figitaki/Puffin/Puffin.csv

Id | Designator | Footprint | Quantity | Designation | Supplier and ref
1 | S43,S39,S17,S6,S19,S18,S45,S25,S28,S33,S44,S47,S23,S2,S31,S21,S16,S51,S49,S9,S14,S10,S32,S27,S50,S5,S41,S36,S1,S12,S24,S48,S40,S35,S26,S29,S15,S3,S11,S22,S30,S4,S42,S7,S34,S20,S37,S8,S38,S46,S13 | SW_Hotswap_Kailh_Choc_V1_1.00u | 51 | Keyswitch
2 | U2 | DIP762W50P254L1018H450Q8 | 1 | 6N138
3 | R3 | R_0805_2012Metric | 1 | 220R
4 | J2 | CUI_SJ1-3515 | 1 | MIDI IN | Same Sky SJ1-3515
5 | ST2,ST1 | STAB_choc_2u | 2 | choc_stab
6 | J1 | OLED_128x32 | 1 | OLED_128x32
7 | U1 | ProS3_TH | 1 | ProS3
8 | D53,D54,D55,D56 | D_SOD-323_HandSoldering | 4 | BAT54WS | Diodes Inc BAT54WS-7-F
9 | J3 | CUI_SJ1-3515 | 1 | MIDI OUT | Same Sky SJ1-3515
10 | R2 | R_0805_2012Metric | 1 | 470R
11 | D28,D40,D10,D33,D11,D39,D26,D35,D14,D25,D29,D19,D9,D18,D32,D12,D27,D23,D16,D20,D6,D51,D21,D44,D37,D7,D5,D1,D34,D38,D24,D49,D47,D50,D41,D15,D45,D22,D3,D43,D36,D46,D42,D48,D13,D4,D8,D31,D2,D30,D17 | Nexperia_CFP3_SOD-123W | 51 | D_Small
12 | C32,C10,C23,C45,C15,C25,C34,C13,C36,C14,C6,C31,C18,C46,C26,C9,C11,C4,C48,C39,C5,C7,C41,C43,C47,C28,C50,C33,C40,C35,C16,C3,C37,C29,C20,C12,C51,C24,C17,C21,C27,C19,C44,C2,C49,C30,C42,C38,C8,C1,C22 | C_0805 | 51 | 100nF
13 | LED11,LED14,LED17,LED38,LED35,LED40,LED9,LED37,LED12,LED13,LED39,LED15,LED16,LED41,LED8,LED36,LED33,LED34,LED31,LED32,LED42,LED10,LED18,LED7 | LED_choc_6028R-ROT | 24 | SK6812
14 | LED23,LED25,LED21,LED20,LED51,LED28,LED3,LED29,LED47,LED49,LED26,LED6,LED4,LED2,LED5,LED48,LED46,LED1,LED44,LED27,LED45,LED30,LED24,LED22,LED43,LED50,LED19 | LED_choc_6028R | 27 | SK6812
15 | R5 | R_0805_2012Metric | 1 | 300R
16 | R1 | R_0805_2012Metric | 1 | 4.7K
17 | R4 | R_0805_2012Metric | 1 | 33R 0.5W | Panasonic ERJ-P06J330V
18 | R6 | R_0805_2012Metric | 1 | 10R 0.5W | Panasonic ERJ-P06J100V
19 | R7 | R_0805_2012Metric | 1 | 10k
20 | U3 | SOT-23-6 | 1 | 74LVC2G34 | Texas Instruments SN74LVC2G34DBVR
21 | C52 | C_0805_2012Metric | 1 | 100nF | Samsung CL21B104KBCNNNC
