figitaki/Puffin/Puffin.kicad_pcb

## KiCad design Puffin.kicad_pcb (2026-11-13)

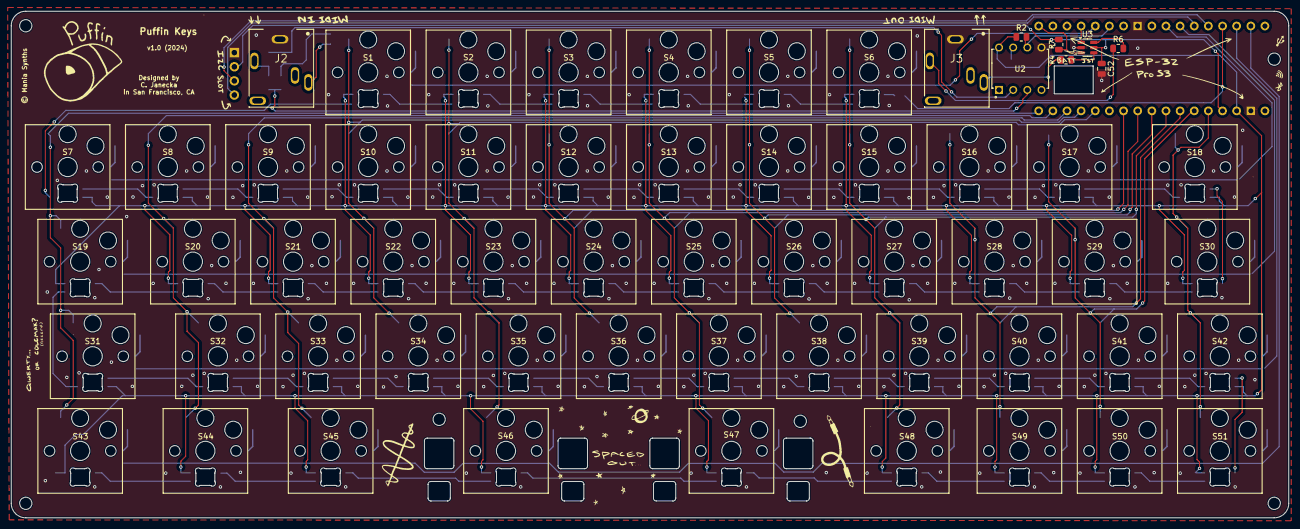
[picture p1: board Puffin.kicad_pcb from above]

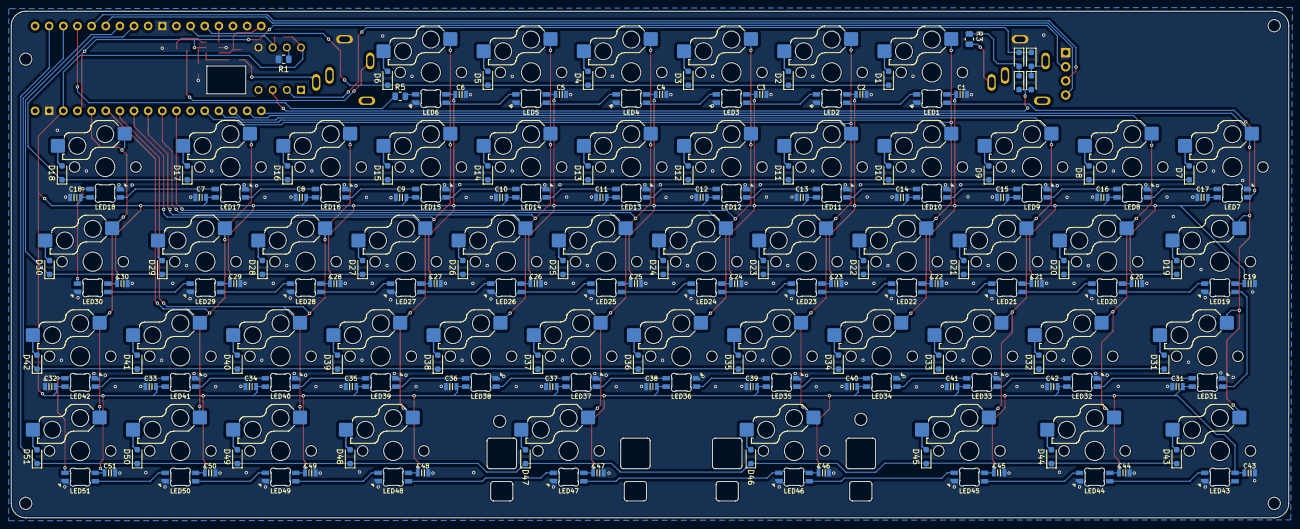
[picture p2: board Puffin.kicad_pcb from below]

Board: 2 copper layers, 229.5 x 91.0 mm, 231 parts (160 on the bottom side), 138 nets.

Parts:
C1, C2, C3, C4, C5, C6, C7, C8, C9, C10, C11, C12, C13, C14, C15, C16, C17, C18, C19, C20, C21, C22, C23, C24, C25, C26, C27, C28, C29, C30, C31, C32, C33, C34, C35, C36, C37, C38, C39, C40, C41, C42, C43, C44, C45, C46, C47, C48, C49, C50, C51: 100nF; C_0805
C52: 100nF; C_0805_2012Metric
D1, D2, D3, D4, D5, D6, D7, D8, D9, D10, D11, D12, D13, D14, D15, D16, D17, D18, D19, D20, D21, D22, D23, D24, D25, D26, D27, D28, D29, D30, D31, D32, D33, D34, D35, D36, D37, D38, D39, D40, D41, D42, D43, D44, D45, D46, D47, D48, D49, D50, D51: D_Small; D_SOD-323_HandSoldering
D53, D54, D55, D56: BAT54WS; D_SOD-323_HandSoldering
H1, H2, H3, H4, H5, H6: MountingHole; MountingHole_2.2mm_M2
J1: OLED_128x32
J2: MIDI IN; CUI_SJ1-3515
J3: MIDI OUT; CUI_SJ1-3515
LED1, LED2, LED3, LED4, LED5, LED6, LED19, LED20, LED21, LED22, LED23, LED24, LED25, LED26, LED27, LED28, LED29, LED30, LED43, LED44, LED45, LED46, LED47, LED48, LED49, LED50, LED51: SK6812; LED_choc_6028R
LED7, LED8, LED9, LED10, LED11, LED12, LED13, LED14, LED15, LED16, LED17, LED18, LED31, LED32, LED33, LED34, LED35, LED36, LED37, LED38, LED39, LED40, LED41, LED42: SK6812; LED_choc_6028R-ROT
PuffinHead: LOGO
R1: 4.7K; R_0805_2012Metric
R2: 470R; R_0805_2012Metric
R3: 220R; R_0805_2012Metric
R4: 33R; R_0805_2012Metric
R5: 300R; R_0805_2012Metric
R6: 10R; R_0805_2012Metric
R7: 10k; R_0805_2012Metric
S1, S2, S3, S4, S5, S6, S7, S8, S9, S10, S11, S12, S13, S14, S15, S16, S17, S18, S19, S20, S21, S22, S23, S24, S25, S26, S27, S28, S29, S30, S31, S32, S33, S34, S35, S36, S37, S38, S39, S40, S41, S42, S43, S44, S45, S46, S47, S48, S49, S50, S51: Keyswitch; SW_Hotswap_Kailh_Choc_V1_1.00u
ST1, ST2: choc_stab; STAB_choc_2u
U1: ProS3; ProS3_TH
U2: 6N138; DIP762W50P254L1018H450Q8
U3: 74LVC2G34; SOT-23-6

Connections:
+3.3V: C52.1, J1.2 (VCC), R7.1, U1.4 (3V3), U3.5
+5V: C1.2, C2.2, C3.2, C4.2, C5.2, C6.2, C7.2, C8.2, C9.2, C10.2, C11.2, C12.2, C13.2, C14.2, C15.2, C16.2, C17.2, C18.2, C19.2, C20.2, C21.2, C22.2, C23.2, C24.2, C25.2, C26.2, C27.2, C28.2, C29.2, C30.2, C31.2, C32.2, C33.2, C34.2, C35.2, C36.2, C37.2, C38.2, C39.2, C40.2, C41.2, C42.2, C43.2, C44.2, C45.2, C46.2, C47.2, C48.2, C49.2, C50.2, C51.2, LED1.1 (VDD), LED2.1 (VDD), LED3.1 (VDD), LED4.1 (VDD), LED5.1 (VDD), LED6.1 (VDD), LED7.1 (VDD), LED8.1 (VDD), LED9.1 (VDD), LED10.1 (VDD), LED11.1 (VDD), LED12.1 (VDD), LED13.1 (VDD), LED14.1 (VDD), LED15.1 (VDD), LED16.1 (VDD), LED17.1 (VDD), LED18.1 (VDD), LED19.1 (VDD), LED20.1 (VDD), LED21.1 (VDD), LED22.1 (VDD), LED23.1 (VDD), LED24.1 (VDD), LED25.1 (VDD), LED26.1 (VDD), LED27.1 (VDD), LED28.1 (VDD), LED29.1 (VDD), LED30.1 (VDD), LED31.1 (VDD), LED32.1 (VDD), LED33.1 (VDD), LED34.1 (VDD), LED35.1 (VDD), LED36.1 (VDD), LED37.1 (VDD), LED38.1 (VDD), LED39.1 (VDD), LED40.1 (VDD), LED41.1 (VDD), LED42.1 (VDD), LED43.1 (VDD), LED44.1 (VDD), LED45.1 (VDD), LED46.1 (VDD), LED47.1 (VDD), LED48.1 (VDD), LED49.1 (VDD), LED50.1 (VDD), LED51.1 (VDD), R2.1, U1.3 (5V), U2.8 (VCC)
/MIDI Interface/TIP_IN: D55.2 (A), D56.1 (K), J2.2
Col1: S7.1, S19.1, S31.1, S43.1, U1.17 (IO12)
Col2: S8.1, S20.1, S32.1, S44.1, U1.16 (IO13)
Col3: S9.1, S21.1, S33.1, S45.1, U1.15 (IO14)
Col4: S1.1, S10.1, S22.1, S34.1, U1.14 (IO15)
Col5: S2.1, S11.1, S23.1, S35.1, S46.1, U1.13 (IO16)
Col6: S3.1, S12.1, S24.1, S36.1, U1.11 (IO0)
Col7: S4.1, S13.1, S25.1, S37.1, S47.1, U1.10 (IO21)
Col8: S5.1, S14.1, S26.1, S38.1, U1.9 (IO5)
Col9: S6.1, S15.1, S27.1, S39.1, S48.1, U1.8 (IO4)
Col10: S16.1, S28.1, S40.1, S49.1, U1.7 (IO3)
Col11: S17.1, S29.1, S41.1, S50.1, U1.6 (IO2)
Col12: S18.1, S30.1, S42.1, S51.1, U1.5 (IO1)
GND: C1.1, C2.1, C3.1, C4.1, C5.1, C6.1, C7.1, C8.1, C9.1, C10.1, C11.1, C12.1, C13.1, C14.1, C15.1, C16.1, C17.1, C18.1, C19.1, C20.1, C21.1, C22.1, C23.1, C24.1, C25.1, C26.1, C27.1, C28.1, C29.1, C30.1, C31.1, C32.1, C33.1, C34.1, C35.1, C36.1, C37.1, C38.1, C39.1, C40.1, C41.1, C42.1, C43.1, C44.1, C45.1, C46.1, C47.1, C48.1, C49.1, C50.1, C51.1, C52.2, J1.1 (GND), J2.1, J3.1, LED1.4 (VSS), LED2.4 (VSS), LED3.4 (VSS), LED4.4 (VSS), LED5.4 (VSS), LED6.4 (VSS), LED7.4 (VSS), LED8.4 (VSS), LED9.4 (VSS), LED10.4 (VSS), LED11.4 (VSS), LED12.4 (VSS), LED13.4 (VSS), LED14.4 (VSS), LED15.4 (VSS), LED16.4 (VSS), LED17.4 (VSS), LED18.4 (VSS), LED19.4 (VSS), LED20.4 (VSS), LED21.4 (VSS), LED22.4 (VSS), LED23.4 (VSS), LED24.4 (VSS), LED25.4 (VSS), LED26.4 (VSS), LED27.4 (VSS), LED28.4 (VSS), LED29.4 (VSS), LED30.4 (VSS), LED31.4 (VSS), LED32.4 (VSS), LED33.4 (VSS), LED34.4 (VSS), LED35.4 (VSS), LED36.4 (VSS), LED37.4 (VSS), LED38.4 (VSS), LED39.4 (VSS), LED40.4 (VSS), LED41.4 (VSS), LED42.4 (VSS), LED43.4 (VSS), LED44.4 (VSS), LED45.4 (VSS), LED46.4 (VSS), LED47.4 (VSS), LED48.4 (VSS), LED49.4 (VSS), LED50.4 (VSS), LED51.4 (VSS), R1.1, U1.2 (GND), U1.25 (GND), U2.5 (GND), U3.2
LED DATA: R5.1, U1.31 (IO34)
MIDI OUT RING: R7.2, U1.18 (IO42), U3.3
MIDI OUT TIP: U1.21 (IO39), U3.1
unnamed: D1.2 (A), S1.2
unnamed: D2.2 (A), S2.2
unnamed: D3.2 (A), S3.2
unnamed: D4.2 (A), S4.2
unnamed: D5.2 (A), S5.2
unnamed: D6.2 (A), S6.2
unnamed: D7.2 (A), S7.2
unnamed: D8.2 (A), S8.2
unnamed: D9.2 (A), S9.2
unnamed: D10.2 (A), S10.2
unnamed: D11.2 (A), S11.2
unnamed: D12.2 (A), S12.2
unnamed: D13.2 (A), S13.2
unnamed: D14.2 (A), S14.2
unnamed: D15.2 (A), S15.2
unnamed: D16.2 (A), S16.2
unnamed: D17.2 (A), S17.2
unnamed: D18.2 (A), S18.2
unnamed: D19.2 (A), S19.2
unnamed: D20.2 (A), S20.2
unnamed: D21.2 (A), S21.2
unnamed: D22.2 (A), S22.2
unnamed: D23.2 (A), S23.2
unnamed: D24.2 (A), S24.2
unnamed: D25.2 (A), S25.2
unnamed: D26.2 (A), S26.2
unnamed: D27.2 (A), S27.2
unnamed: D28.2 (A), S28.2
unnamed: D29.2 (A), S29.2
unnamed: D30.2 (A), S30.2
unnamed: D31.2 (A), S31.2
unnamed: D32.2 (A), S32.2
unnamed: D33.2 (A), S33.2
unnamed: D34.2 (A), S34.2
unnamed: D35.2 (A), S35.2
unnamed: D36.2 (A), S36.2
unnamed: D37.2 (A), S37.2
unnamed: D38.2 (A), S38.2
unnamed: D39.2 (A), S39.2
unnamed: D40.2 (A), S40.2
unnamed: D41.2 (A), S41.2
unnamed: D42.2 (A), S42.2
unnamed: D43.2 (A), S43.2
unnamed: D44.2 (A), S44.2
unnamed: D45.2 (A), S45.2
unnamed: D46.2 (A), S46.2
unnamed: D47.2 (A), S47.2
unnamed: D48.2 (A), S48.2
unnamed: D49.2 (A), S49.2
unnamed: D50.2 (A), S50.2
unnamed: D51.2 (A), S51.2
unnamed: D53.2 (A), D54.1 (K), R3.2
unnamed: D53.1 (K), D55.1 (K), U2.2 (C1)
unnamed: D54.2 (A), D56.2 (A), U2.3 (C2)
unnamed: J1.3 (SCL), U1.30 (IO9_SCL)
unnamed: J1.4 (SDA), U1.29 (IO8_SDA)
unnamed: J2.3, R3.1
unnamed: J3.2, R6.1
unnamed: J3.3, R4.1
unnamed: LED1.3 (DIN), LED2.2 (DOUT)
unnamed: LED1.2 (DOUT), LED7.3 (DIN)
unnamed: LED2.3 (DIN), LED3.2 (DOUT)
unnamed: LED3.3 (DIN), LED4.2 (DOUT)
unnamed: LED4.3 (DIN), LED5.2 (DOUT)
unnamed: LED5.3 (DIN), LED6.2 (DOUT)
unnamed: LED6.3 (DIN), R5.2
unnamed: LED7.2 (DOUT), LED8.3 (DIN)
unnamed: LED8.2 (DOUT), LED9.3 (DIN)
unnamed: LED9.2 (DOUT), LED10.3 (DIN)
unnamed: LED10.2 (DOUT), LED11.3 (DIN)
unnamed: LED11.2 (DOUT), LED12.3 (DIN)
unnamed: LED12.2 (DOUT), LED13.3 (DIN)
unnamed: LED13.2 (DOUT), LED14.3 (DIN)
unnamed: LED14.2 (DOUT), LED15.3 (DIN)
unnamed: LED15.2 (DOUT), LED16.3 (DIN)
unnamed: LED16.2 (DOUT), LED17.3 (DIN)
unnamed: LED17.2 (DOUT), LED18.3 (DIN)
unnamed: LED18.2 (DOUT), LED30.3 (DIN)
unnamed: LED19.3 (DIN), LED20.2 (DOUT)
unnamed: LED19.2 (DOUT), LED31.3 (DIN)
unnamed: LED20.3 (DIN), LED21.2 (DOUT)
unnamed: LED21.3 (DIN), LED22.2 (DOUT)
unnamed: LED22.3 (DIN), LED23.2 (DOUT)
unnamed: LED23.3 (DIN), LED24.2 (DOUT)
unnamed: LED24.3 (DIN), LED25.2 (DOUT)
unnamed: LED25.3 (DIN), LED26.2 (DOUT)
unnamed: LED26.3 (DIN), LED27.2 (DOUT)
unnamed: LED27.3 (DIN), LED28.2 (DOUT)
unnamed: LED28.3 (DIN), LED29.2 (DOUT)
unnamed: LED29.3 (DIN), LED30.2 (DOUT)
unnamed: LED31.2 (DOUT), LED32.3 (DIN)
unnamed: LED32.2 (DOUT), LED33.3 (DIN)
unnamed: LED33.2 (DOUT), LED34.3 (DIN)
unnamed: LED34.2 (DOUT), LED35.3 (DIN)
unnamed: LED35.2 (DOUT), LED36.3 (DIN)
unnamed: LED36.2 (DOUT), LED37.3 (DIN)
unnamed: LED37.2 (DOUT), LED38.3 (DIN)
unnamed: LED38.2 (DOUT), LED39.3 (DIN)
unnamed: LED39.2 (DOUT), LED40.3 (DIN)
unnamed: LED40.2 (DOUT), LED41.3 (DIN)
unnamed: LED41.2 (DOUT), LED42.3 (DIN)
unnamed: LED42.2 (DOUT), LED51.3 (DIN)
unnamed: LED43.3 (DIN), LED44.2 (DOUT)
unnamed: LED44.3 (DIN), LED45.2 (DOUT)
unnamed: LED45.3 (DIN), LED46.2 (DOUT)
unnamed: LED46.3 (DIN), LED47.2 (DOUT)
unnamed: LED47.3 (DIN), LED48.2 (DOUT)
unnamed: LED48.3 (DIN), LED49.2 (DOUT)
unnamed: LED49.3 (DIN), LED50.2 (DOUT)
unnamed: LED50.3 (DIN), LED51.2 (DOUT)
unnamed: R4.2, U3.4
unnamed: R6.2, U3.6
unnamed: R1.2, U2.7 (VO1)
RX MIDI: R2.2, U1.23 (RX), U2.6 (VO2)
Row1: D1.1 (K), D2.1 (K), D3.1 (K), D4.1 (K), D5.1 (K), D6.1 (K), U1.22 (IO38)
Row2: D7.1 (K), D8.1 (K), D9.1 (K), D10.1 (K), D11.1 (K), D12.1 (K), D13.1 (K), D14.1 (K), D15.1 (K), D16.1 (K), D17.1 (K), D18.1 (K), U1.27 (IO6)
Row3: D19.1 (K), D20.1 (K), D21.1 (K), D22.1 (K), D23.1 (K), D24.1 (K), D25.1 (K), D26.1 (K), D27.1 (K), D28.1 (K), D29.1 (K), D30.1 (K), U1.28 (IO7)
Row4: D31.1 (K), D32.1 (K), D33.1 (K), D34.1 (K), D35.1 (K), D36.1 (K), D37.1 (K), D38.1 (K), D39.1 (K), D40.1 (K), D41.1 (K), D42.1 (K), U1.32 (IO36)
Row5: D43.1 (K), D44.1 (K), D45.1 (K), D46.1 (K), D47.1 (K), D48.1 (K), D49.1 (K), D50.1 (K), D51.1 (K), U1.33 (IO37)
