figitaki/Puffin/(commit log)

2026-11-11 Prepare orb toolchains and cache firmware dependencies
    Amp-Thread-ID: https://ampcode.com/threads/T-01a1c909-0481-7210-8feb-8b29122e73a8
2026-11-13 Rev B: TRS MIDI Type A and Type B
    MIDI OUT: tip (IO39) and ring (IO42) each driven through a 74LVC2G34
    buffer on +3.3V with CA-033 resistors (ring 33R, tip 10R, 0.5W), so
    firmware can pick Type A or Type B and the output works on battery.
    R7 pulls IO42 up so both lines idle HIGH at reset.
    MIDI IN: BAT54WS bridge (D53-D56) in front of the 6N138 accepts either
    polarity; D52 removed. J2/J3 MPN corrected to SJ1-3515 to match the
    footprint. Parts list, README, and revision notes updated.
    Amp-Thread-ID: https://ampcode.com/threads/T-01a1d667-afe3-71f0-8953-a3379ad87e16
    [MIDI.kicad_sch, Puffin.csv, Puffin.kicad_pcb, Puffin.kicad_sch]
