figitaki/Puffin/(notices)

Notices in the files:
Puffin.kicad_pcb:
© Mania Synths
